duncanmwanik/Moodlamp-Attachment/hardware/images/3d2.png

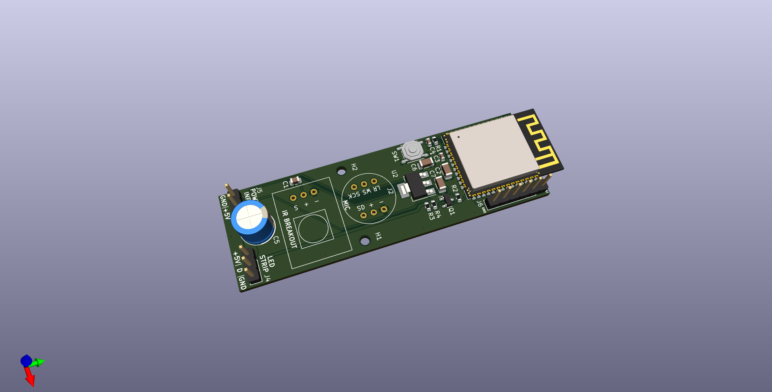
hardware/images/3d2.png
