duncanmwanik/Moodlamp-Attachment/hardware/images/3d.png

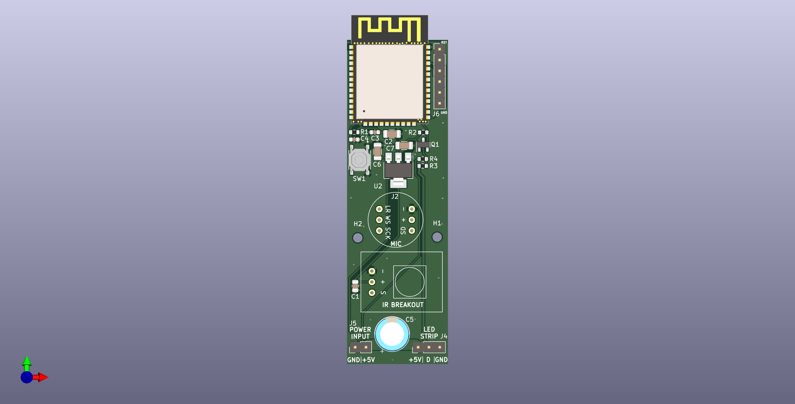
hardware/images/3d.png
