duncanmwanik/Moodlamp-Attachment/flutter_apk/screenshots/colors.jpeg

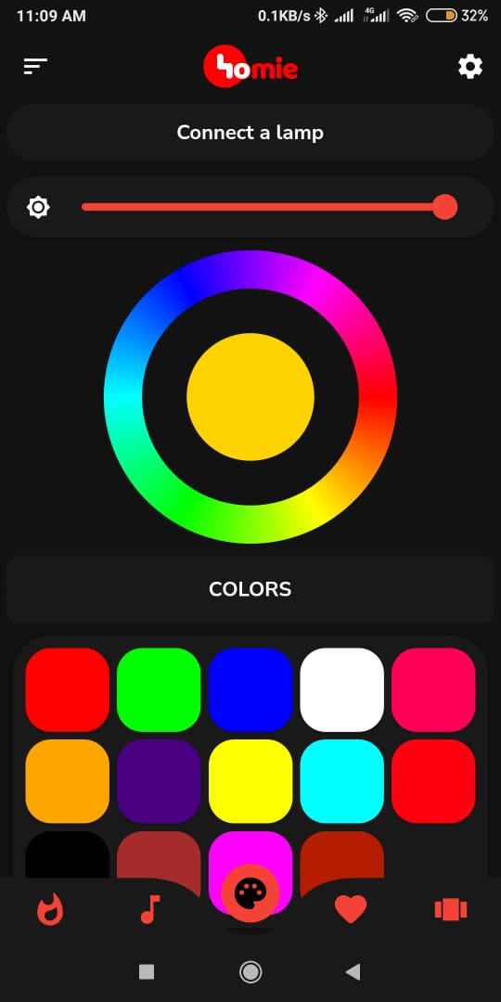
flutter_apk/screenshots/colors.jpeg
