duncanmwanik/Moodlamp-Attachment/flutter_apk/screenshots/fav.jpeg

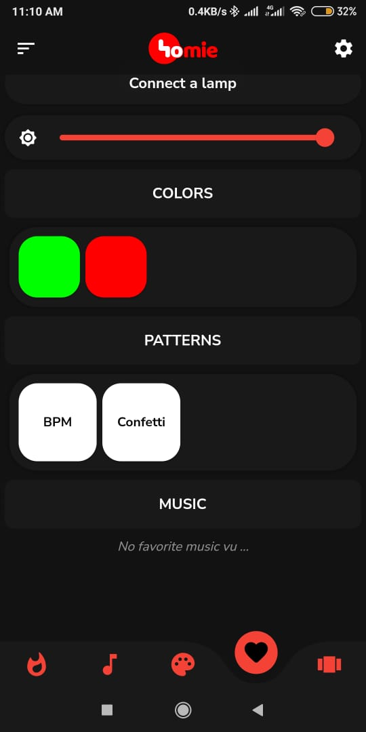
flutter_apk/screenshots/fav.jpeg
