duncanmwanik/Moodlamp-Attachment/flutter_apk/screenshots/music.jpeg

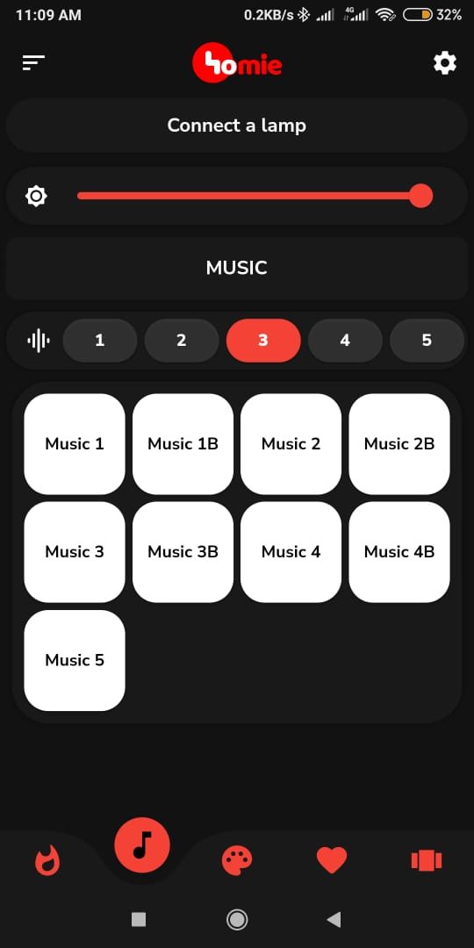
flutter_apk/screenshots/music.jpeg
