duncanmwanik/Moodlamp-Attachment/flutter_apk/screenshots/patterns.jpeg

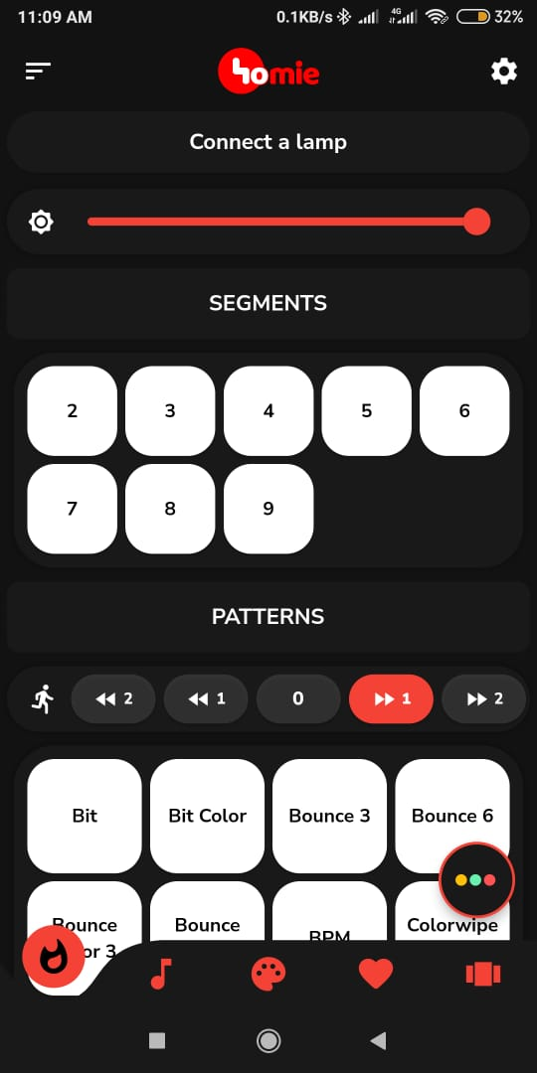
flutter_apk/screenshots/patterns.jpeg
