duncanmwanik/Moodlamp-Attachment/hardware/images/pcb2.png

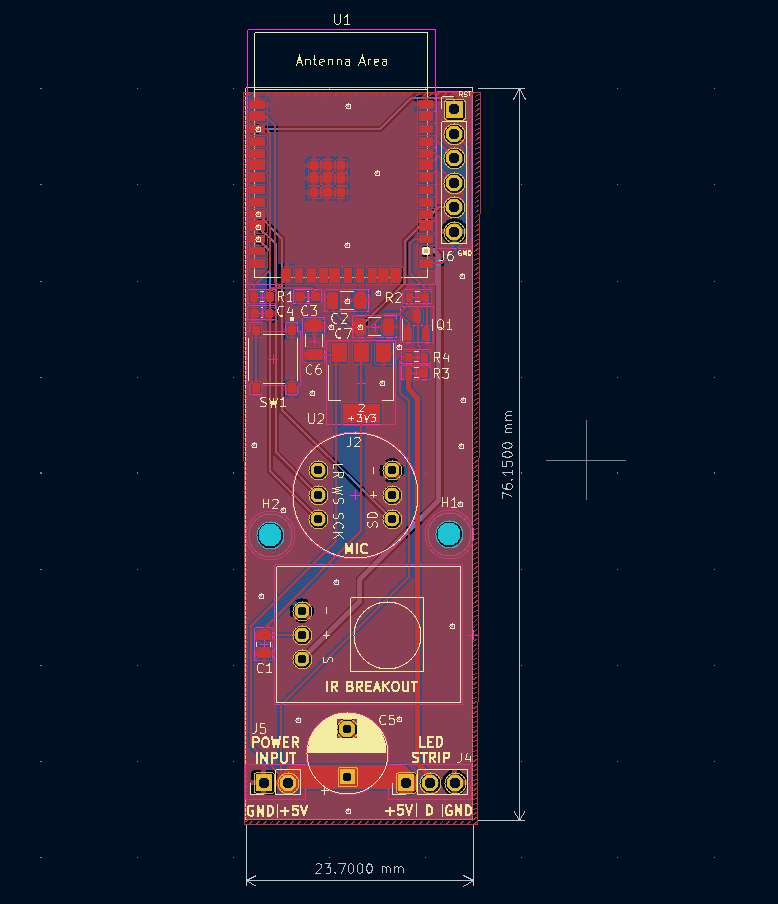
hardware/images/pcb2.png
