duncanmwanik/Moodlamp-Attachment/hardware/images/pcb.png

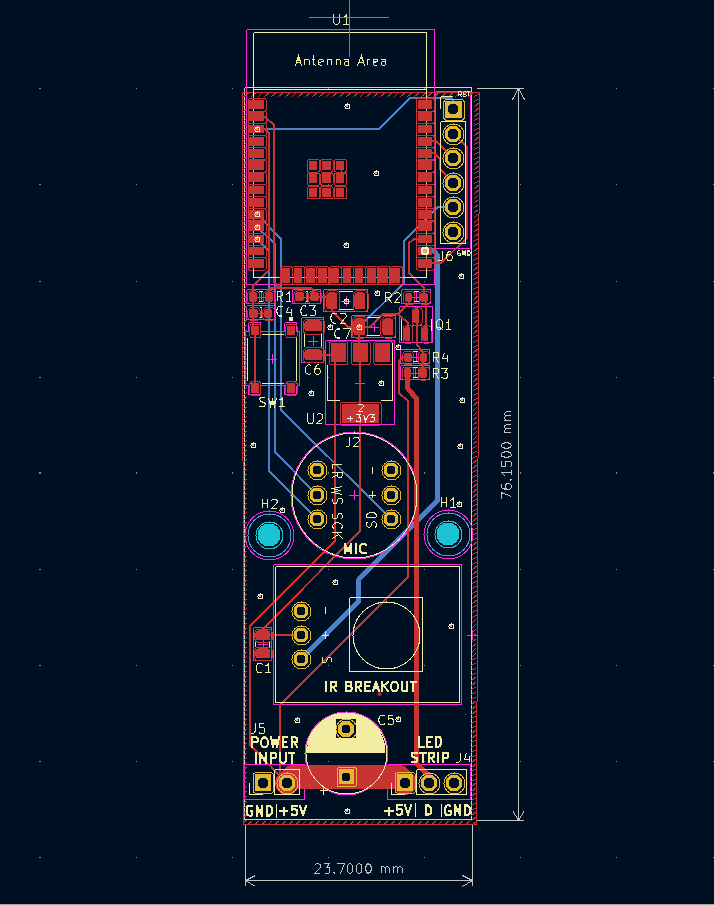
hardware/images/pcb.png
