duncanmwanik/Moodlamp-Attachment/hardware/src/MoodLamp.kicad_pcb

## KiCad design hardware/src/MoodLamp.kicad_pcb (2023-03-10)

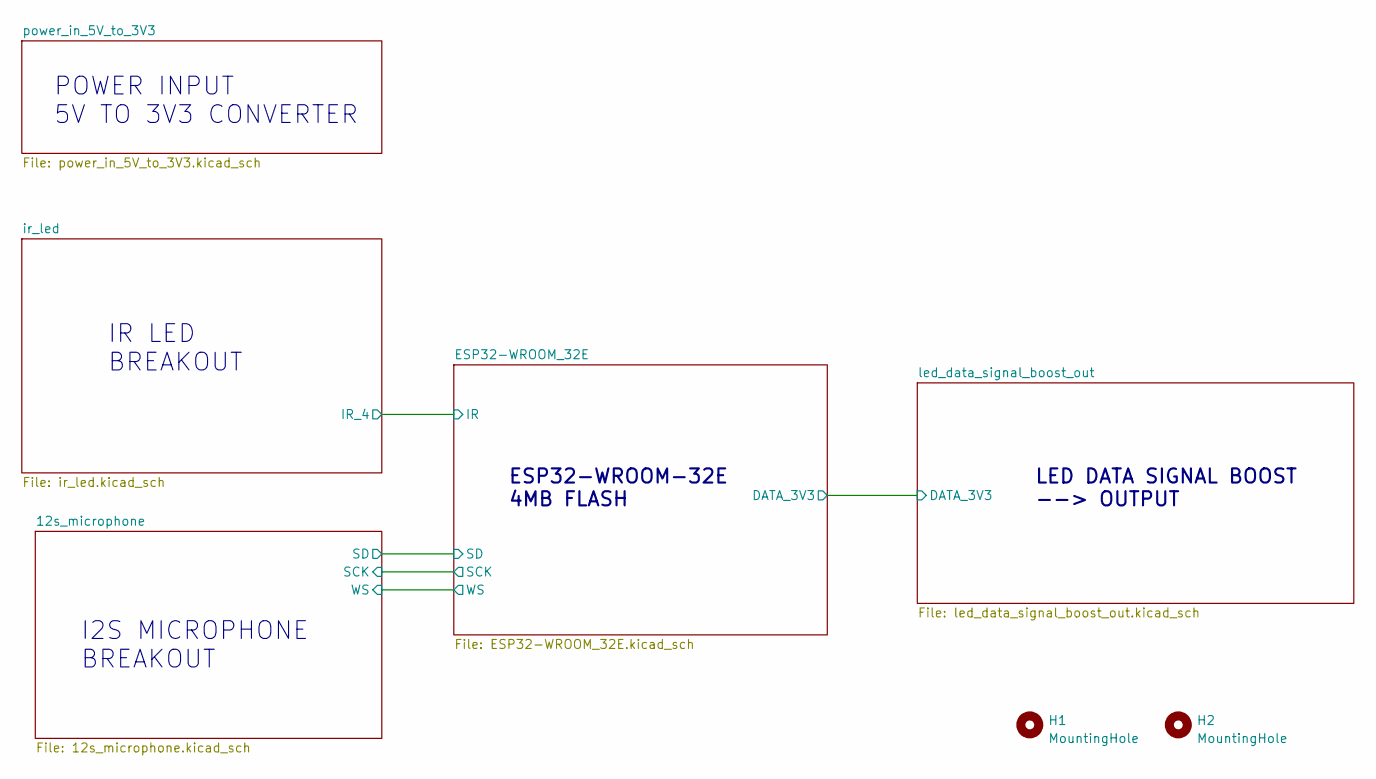
[picture p9: schematic MoodLamp.kicad_sch]

Parts:
H1, H2: MountingHole; MountingHole_2.2mm_M2

Notes on the sheet:
ESP32-WROOM-32E 4MB FLASH
I2S MICROPHONE BREAKOUT
LED DATA SIGNAL BOOST --> OUTPUT
IR LED BREAKOUT
POWER INPUT 5V TO 3V3 CONVERTER

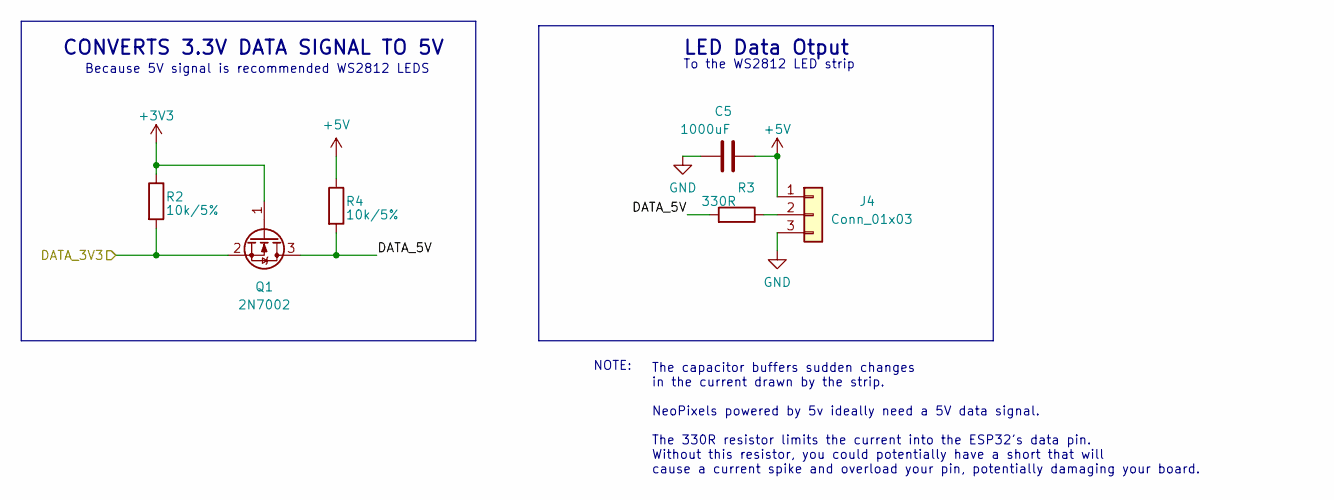
[picture p10: schematic led_data_signal_boost_out.kicad_sch]

Parts:
C5: 1000uF; CP_Radial_D8.0mm_P5.00mm
J4: Conn_01x03; PinHeader_1x03_P2.54mm_Vertical
Q1: 2N7002; SOT-23; MPN 2N7002
R2, R4: 10k/5%; R_0603_1608Metric; MPN 0603WAF1002T5E
R3: 330R; R_0603_1608Metric; MPN 0603WAF3300T5E

Connections:
+3V3: Q1.1 (G), R2.1; also elsewhere on the board
+5V: C5.1, J4.1, R4.1; also elsewhere on the board
/ESP32-WROOM_32E/DATA_3V3: Q1.2 (S), R2.2; also elsewhere on the board
/led_data_signal_boost_out/DATA_5V: Q1.3 (D), R3.2, R4.2
GND: C5.2, J4.3; also elsewhere on the board
unnamed: J4.2, R3.1

Notes on the sheet:
CONVERTS 3.3V DATA SIGNAL TO 5V
NOTE:
Because 5V signal is recommended WS2812 LEDS
The capacitor buffers sudden changes in the current drawn by the strip. NeoPixels powered by 5v ideally need a 5V data signal. The 330R resistor limits the current into the ESP32's data pin. Without this resistor, you could potentially have a short that will cause a current spike and overload your 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
LED Data Otput
To the WS2812 LED strip

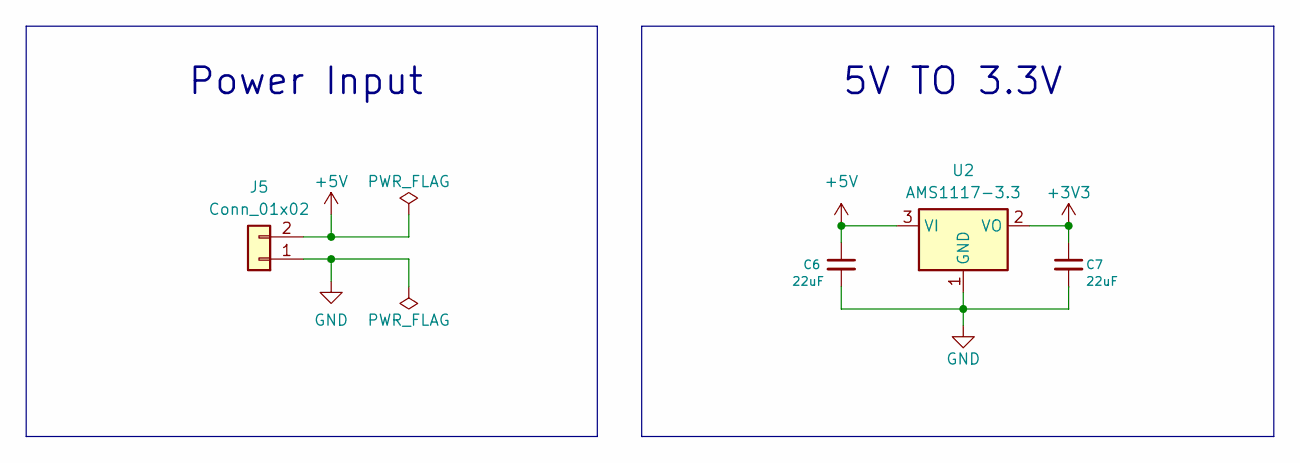
[picture p11: schematic power_in_5V_to_3V3.kicad_sch]

Parts:
C6, C7: 22uF; C_1206_3216Metric; MPN CL31A226KPHNNNE
J5: Conn_01x02; PinHeader_1x02_P2.54mm_Vertical
U2: AMS1117-3.3; SOT-223-3_TabPin2; MPN AMS1117-3.3

Connections:
+3V3: C7.1, U2.2 (VO); also elsewhere on the board
+5V: C6.1, J5.2, U2.3 (VI); also elsewhere on the board
GND: C6.2, C7.2, J5.1, U2.1 (GND); also elsewhere on the board

Notes on the sheet:
Power Input
5V TO 3.3V

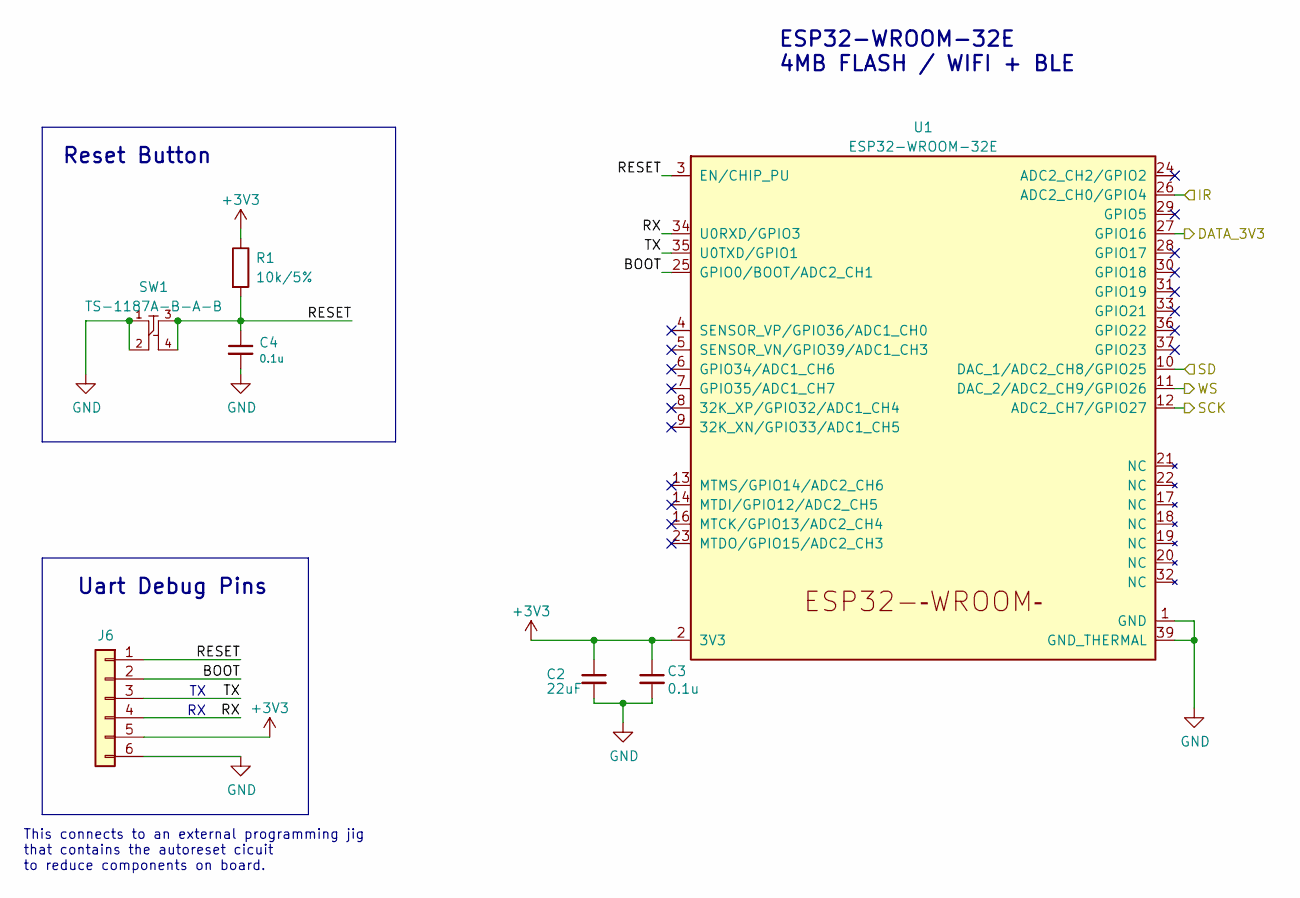
[picture p12: schematic ESP32-WROOM_32E.kicad_sch]

Parts:
C2: 22uF; C_1206_3216Metric; MPN CL31A226KPHNNNE
C3, C4: 0.1u; C_0603_1608Metric; MPN CC0603KRX7R9BB104
J6: Conn_01x06; PinHeader_1x06_P2.54mm_Vertical
R1: 10k/5%; R_0603_1608Metric; MPN 0603WAF1002T5E
SW1: TS-1187A-B-A-B; MPN TS-1187A-B-A-B
U1: ESP32-WROOM-32E; MPN ESP32-WROOM-32E-N4

Connections:
+3V3: C2.1, C3.1, J6.5, R1.1, U1.2 (3V3); also elsewhere on the board
/12s_microphone/SCK: U1.12 (ADC2_CH7/GPIO27); also elsewhere on the board
/12s_microphone/SD: U1.10 (DAC_1/ADC2_CH8/GPIO25); also elsewhere on the board
/12s_microphone/WS: U1.11 (DAC_2/ADC2_CH9/GPIO26); also elsewhere on the board
/ESP32-WROOM_32E/BOOT: J6.2, U1.25 (GPIO0/BOOT/ADC2_CH1)
/ESP32-WROOM_32E/DATA_3V3: U1.27 (GPIO16); also elsewhere on the board
/ESP32-WROOM_32E/IR: U1.26 (ADC2_CH0/GPIO4); also elsewhere on the board
/ESP32-WROOM_32E/RESET: C4.1, J6.1, R1.2, SW1.3, SW1.4, U1.3 (EN/CHIP_PU)
/ESP32-WROOM_32E/RX: J6.4, U1.34 (U0RXD/GPIO3)
/ESP32-WROOM_32E/TX: J6.3, U1.35 (U0TXD/GPIO1)
GND: C2.2, C3.2, C4.2, J6.6, SW1.1, SW1.2, U1.1 (GND), U1.15 (GND), U1.38 (GND), U1.39 (GND_THERMAL); also elsewhere on the board

Notes on the sheet:
This connects to an external programming jig that contains the autoreset cicuit to reduce components on board.
Reset Button
Uart Debug Pins
ESP32-WROOM-32E 4MB FLASH / WIFI + BLE

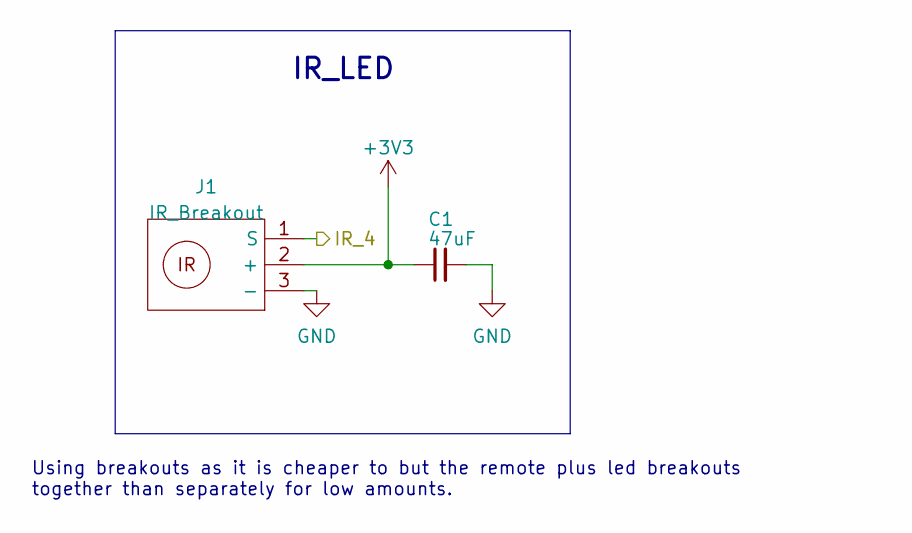
[picture p13: schematic ir_led.kicad_sch]

Parts:
C1: 47uF; C_0805_2012Metric; MPN CL21A476MQYNNNE
J1: IR_Breakout

Connections:
+3V3: C1.1, J1.2 (+); also elsewhere on the board
/ESP32-WROOM_32E/IR: J1.1 (S); also elsewhere on the board
GND: C1.2, J1.3 (-); also elsewhere on the board

Notes on the sheet:
IR_LED
Using breakouts as it is cheaper to but the remote plus led breakouts together than separately for low amounts.

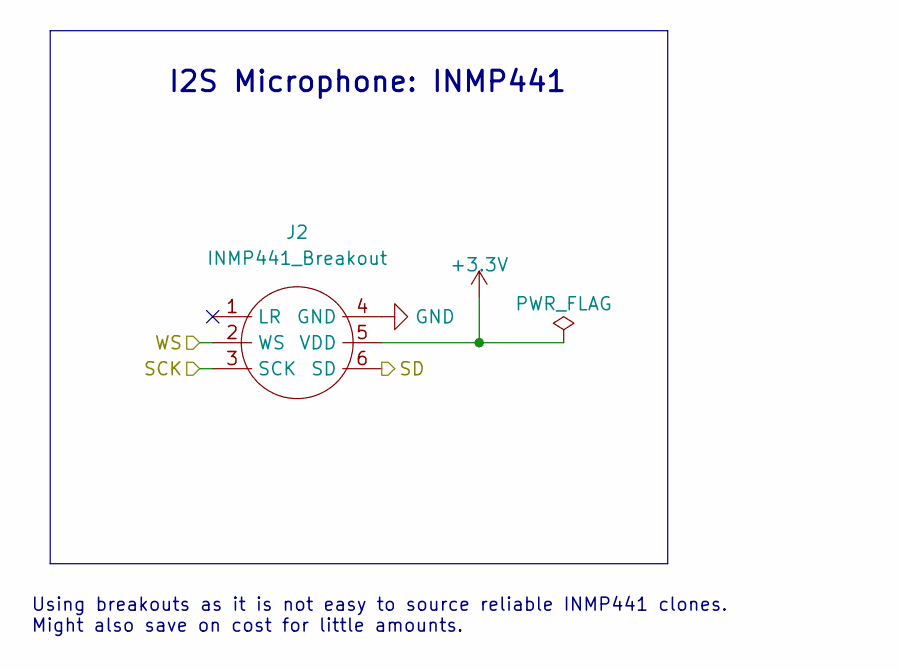
[picture p14: schematic 12s_microphone.kicad_sch]

Parts:
J2: INMP441_Breakout

Connections:
+3.3V: J2.5 (VDD)
/12s_microphone/SCK: J2.3 (SCK); also elsewhere on the board
/12s_microphone/SD: J2.6 (SD); also elsewhere on the board
/12s_microphone/WS: J2.2 (WS); also elsewhere on the board
GND: J2.4 (GND); also elsewhere on the board

Notes on the sheet:
Using breakouts as it is not easy to source reliable INMP441 clones. Might also save on cost for little amounts.
I2S Microphone: INMP441

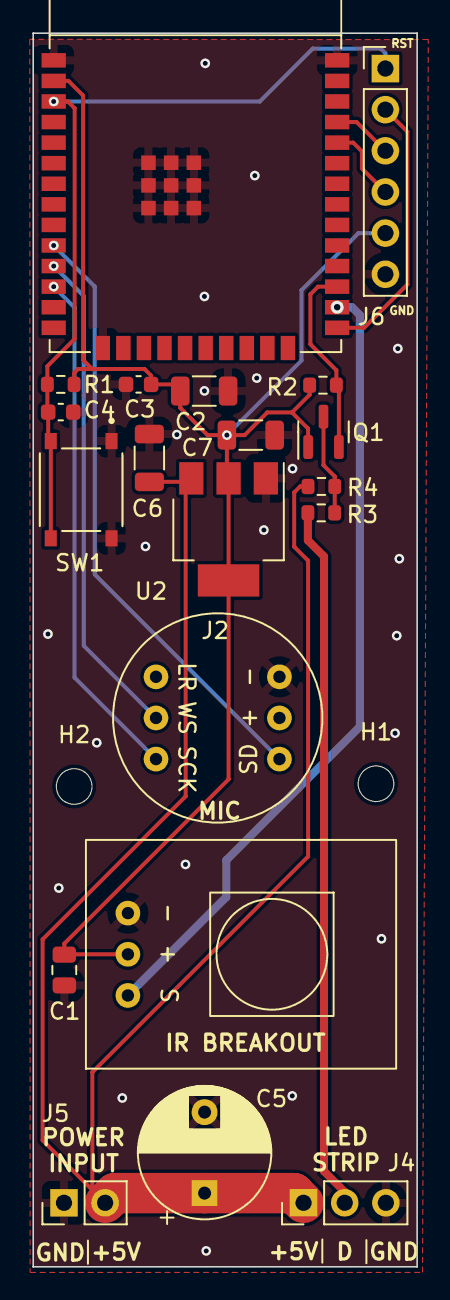
[picture p15: board MoodLamp.kicad_pcb from above]

Board: 2 copper layers, 23.7 x 76.1 mm, 22 parts (0 on the bottom side), 14 nets.
